Lithovox/lux84/docs/lux84backrender.PNG

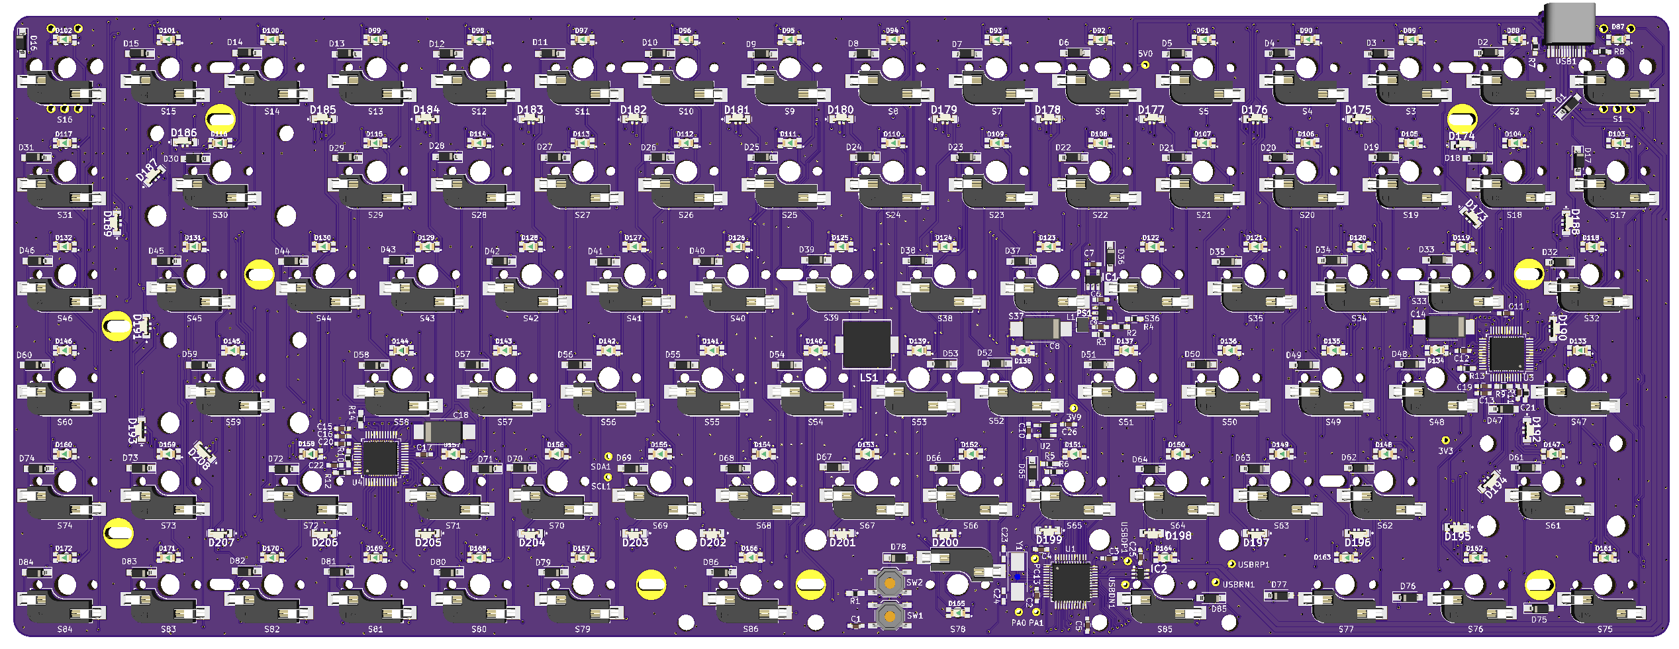
docs/lux84backrender.PNG
