Lithovox/lux84/docs/lux84.pdf

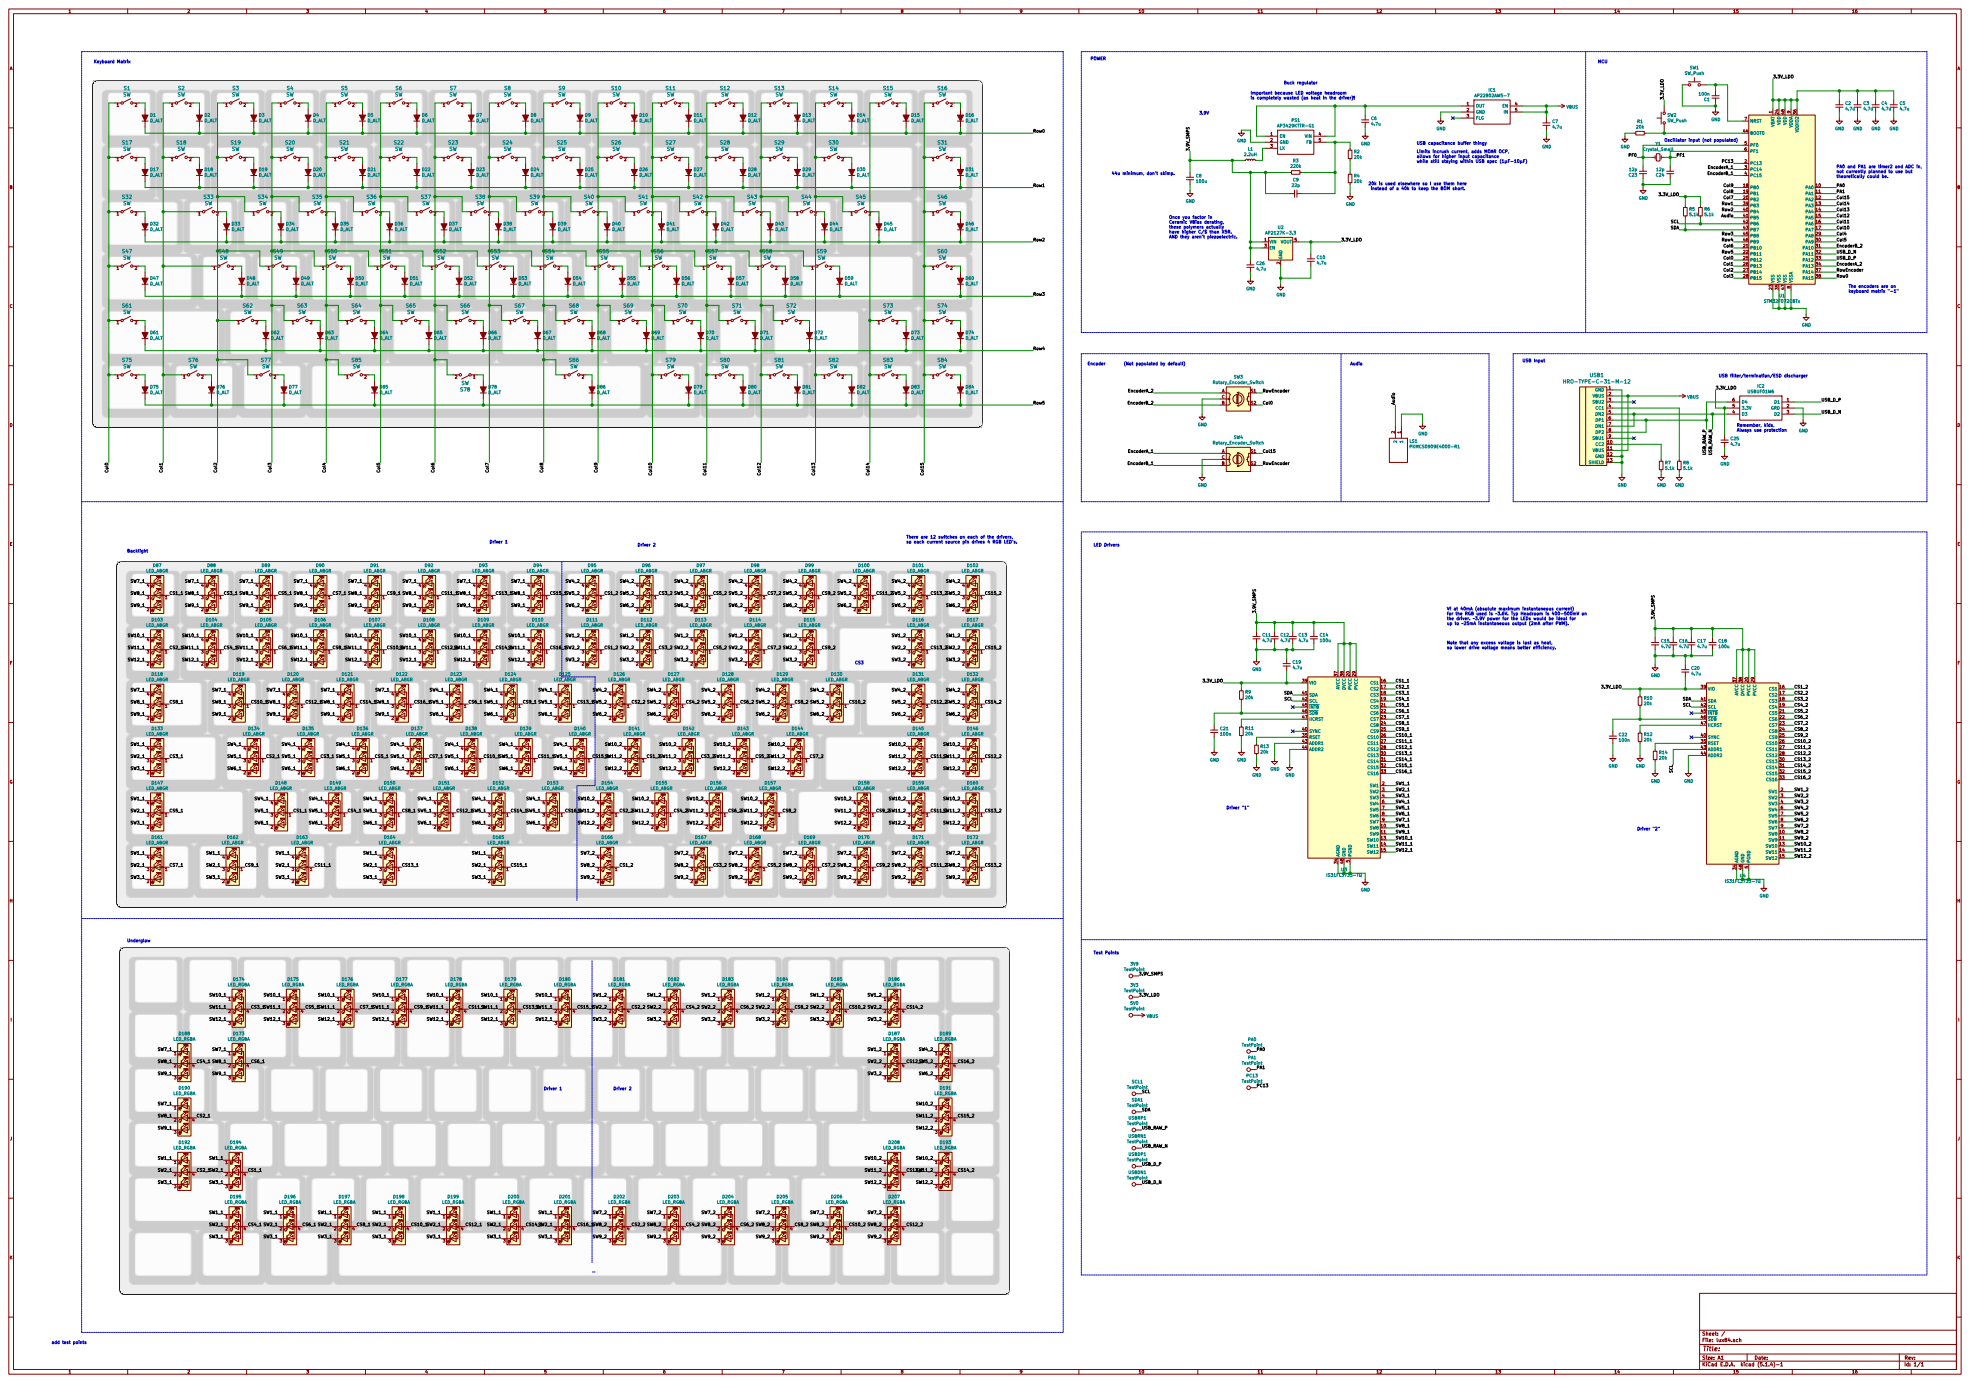
[picture p2: page 1]

Important because LED voltage headroom

9 VDDIO2 36 VSS 23 VSS 35 VSS 47 VSSA

USB capacitance buffer thingy
Limits incrush current, adds MOAR OCP, allows for higher input capacitance

while still staying within USB spec (1µF-10µF)

20k is used elsewhere so I use them here

Once you factor in
Ceramic VBias derating,
these polymers actually
have higher C/$ than X5R.
AND they aren't piezoelectric.

USB filter/termination/ESD discharger Driver 2

Vf at 40mA (absolute maximum instantaneous current)
for the RGB used is 3.6V. Typ Headroom is 400-500mV on
the driver. 3.9V power for the LEDs would be ideal for

up to 25mA instantaneous output (2mA after PWM).

Note that any excess voltage is lost as heat,

Id: 1/1 Title: File: lux84.sch Sheet: /
