Lithovox/lux84/docs/lux84-pcb-rear.pdf

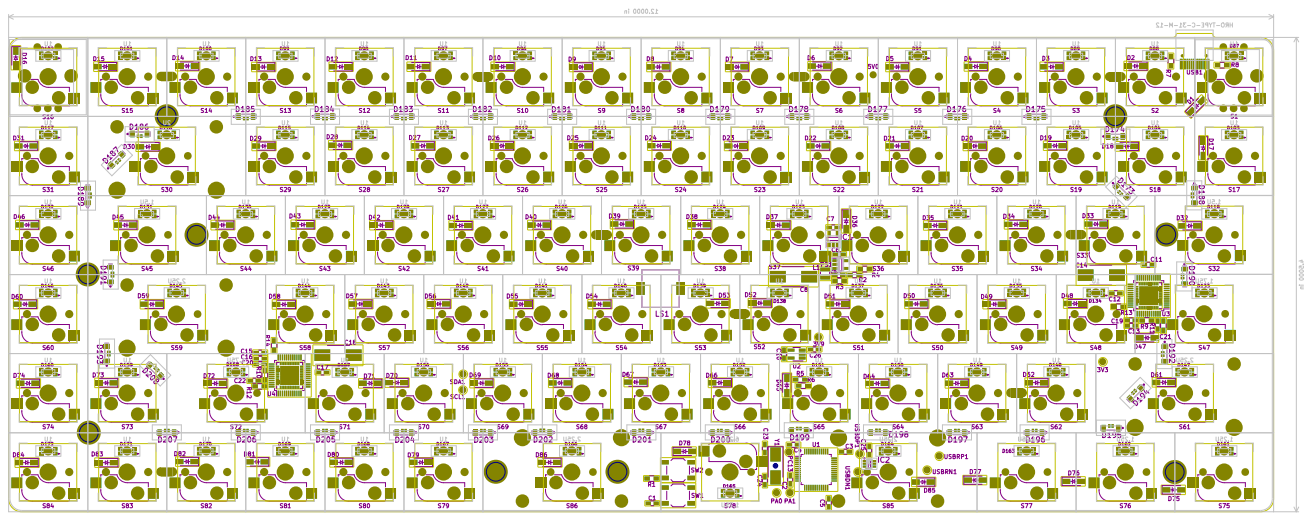
[picture p3: page 1]
