Lithovox/lux84/docs/lux84-pcb.pdf

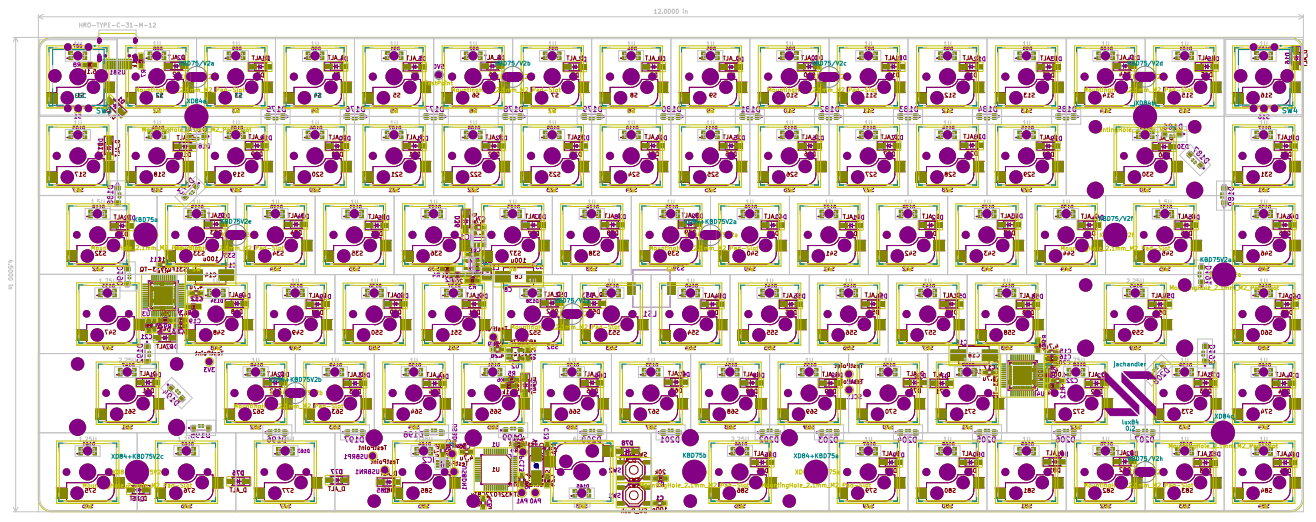
[picture p4: page 1]
