Lithovox/lux84/lux84.sch

## KiCad design lux84.sch (2021-03-26)

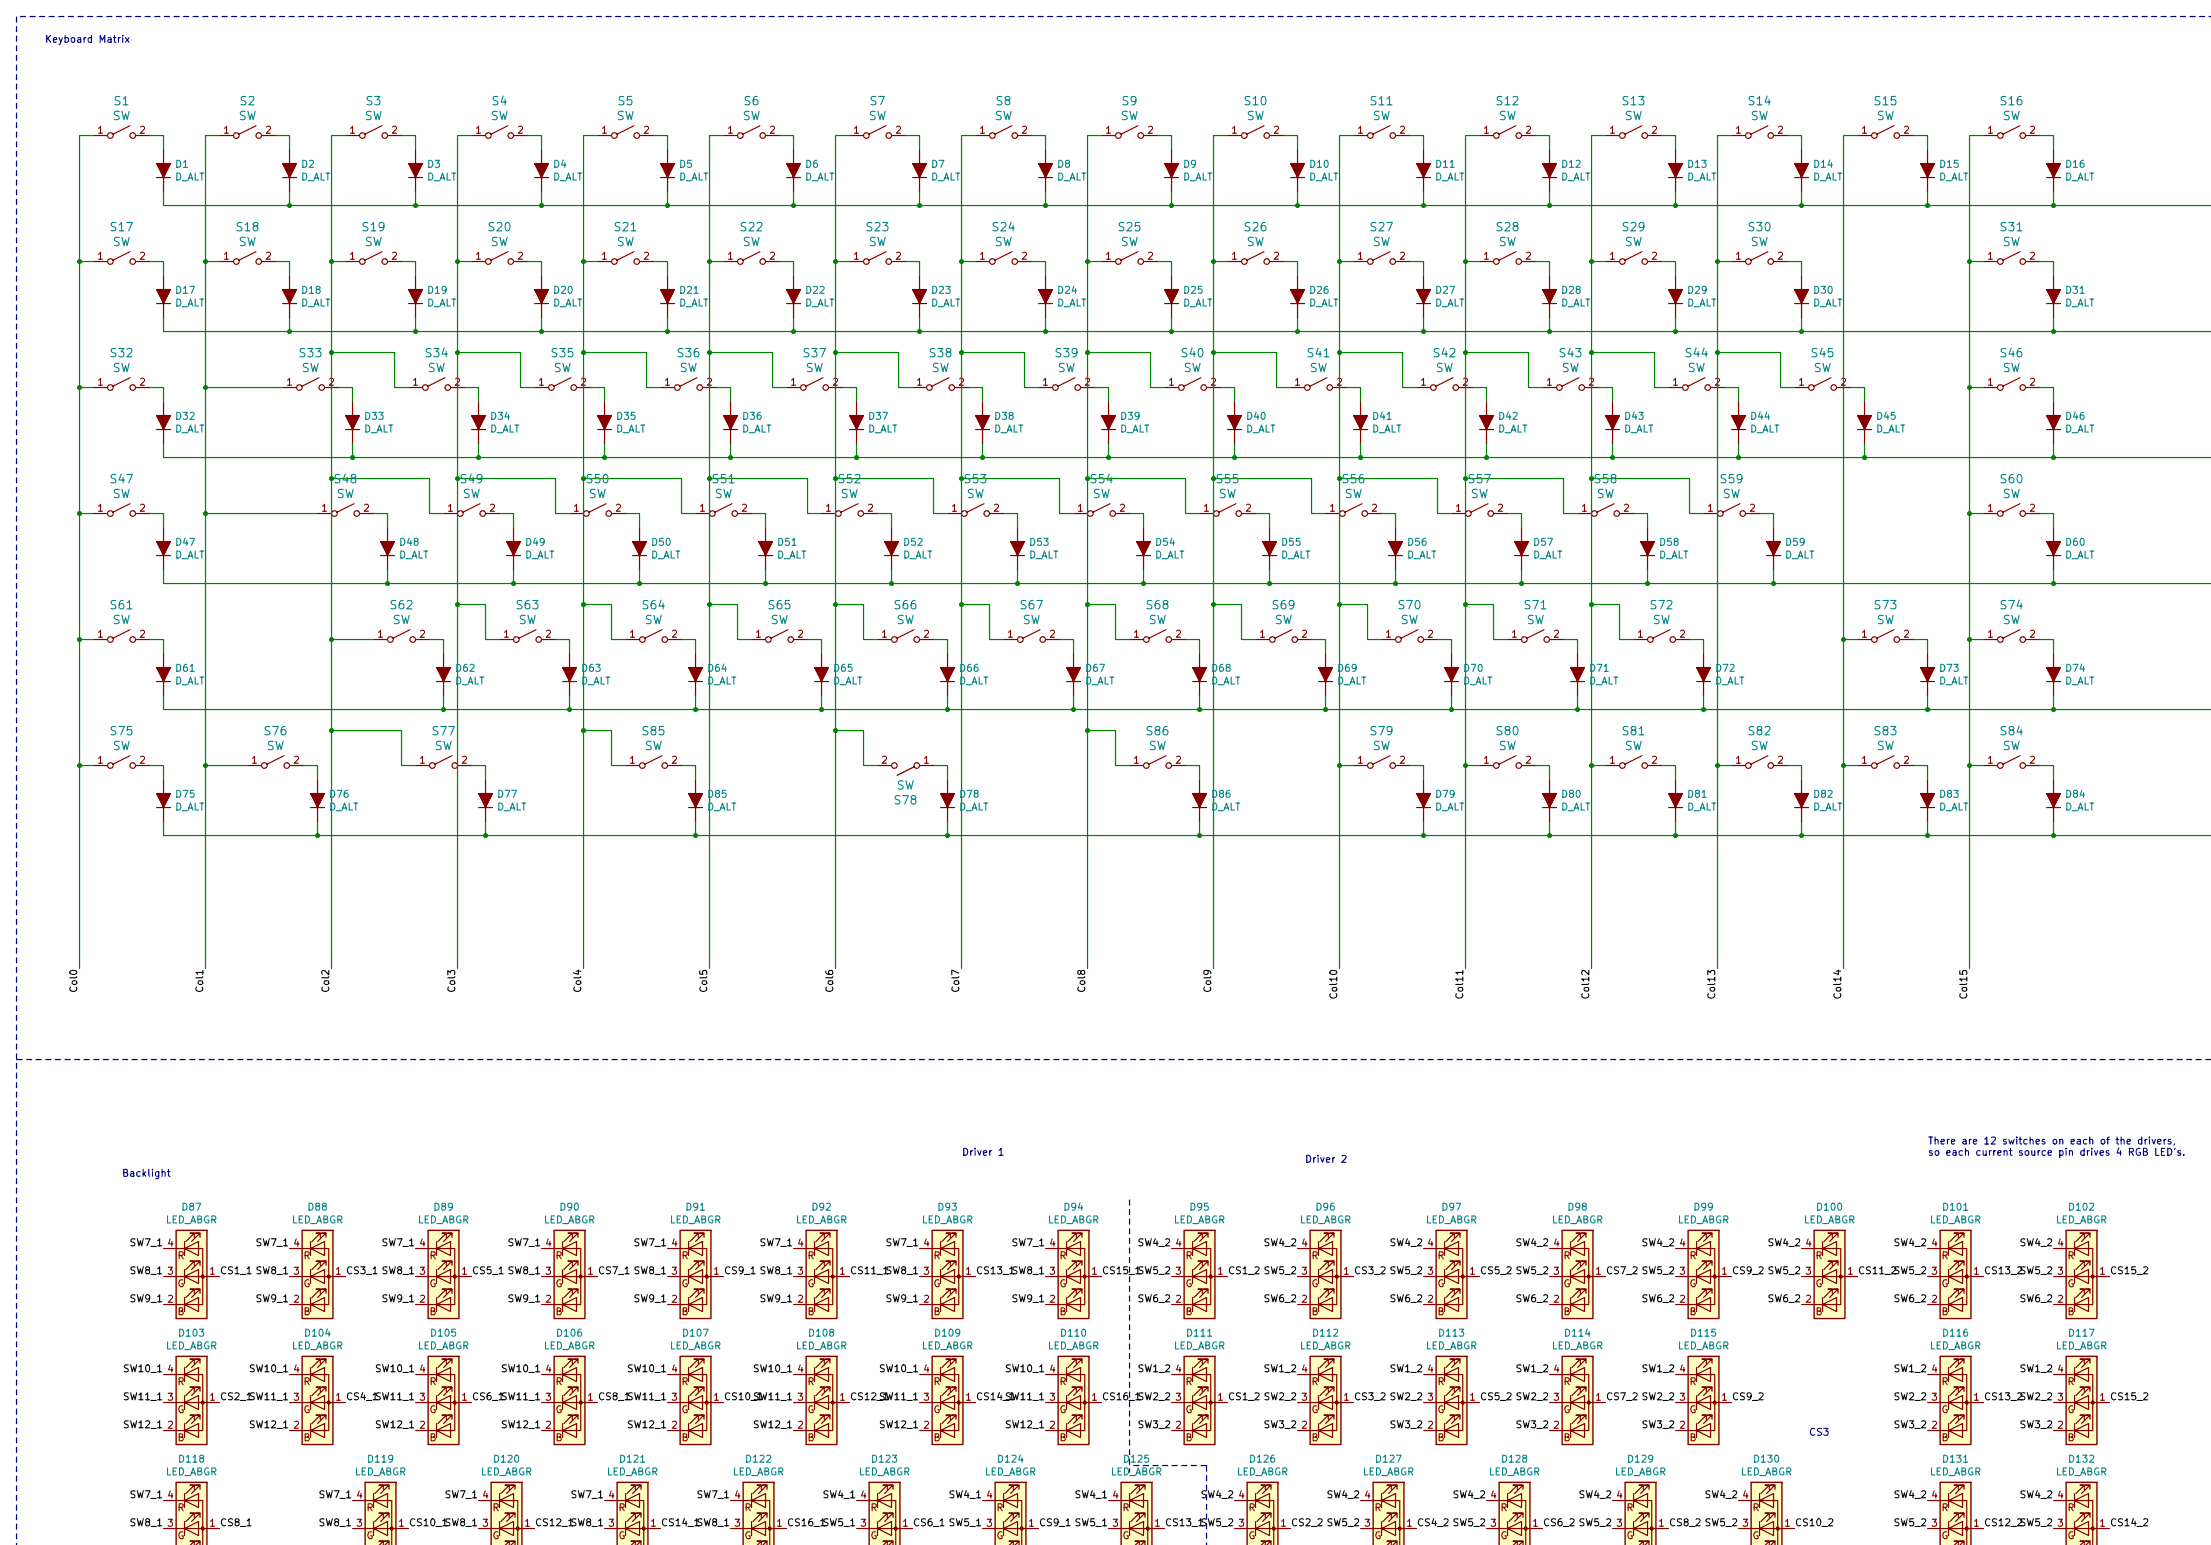
[picture p5: schematic lux84.sch, part in row 1, column 1]

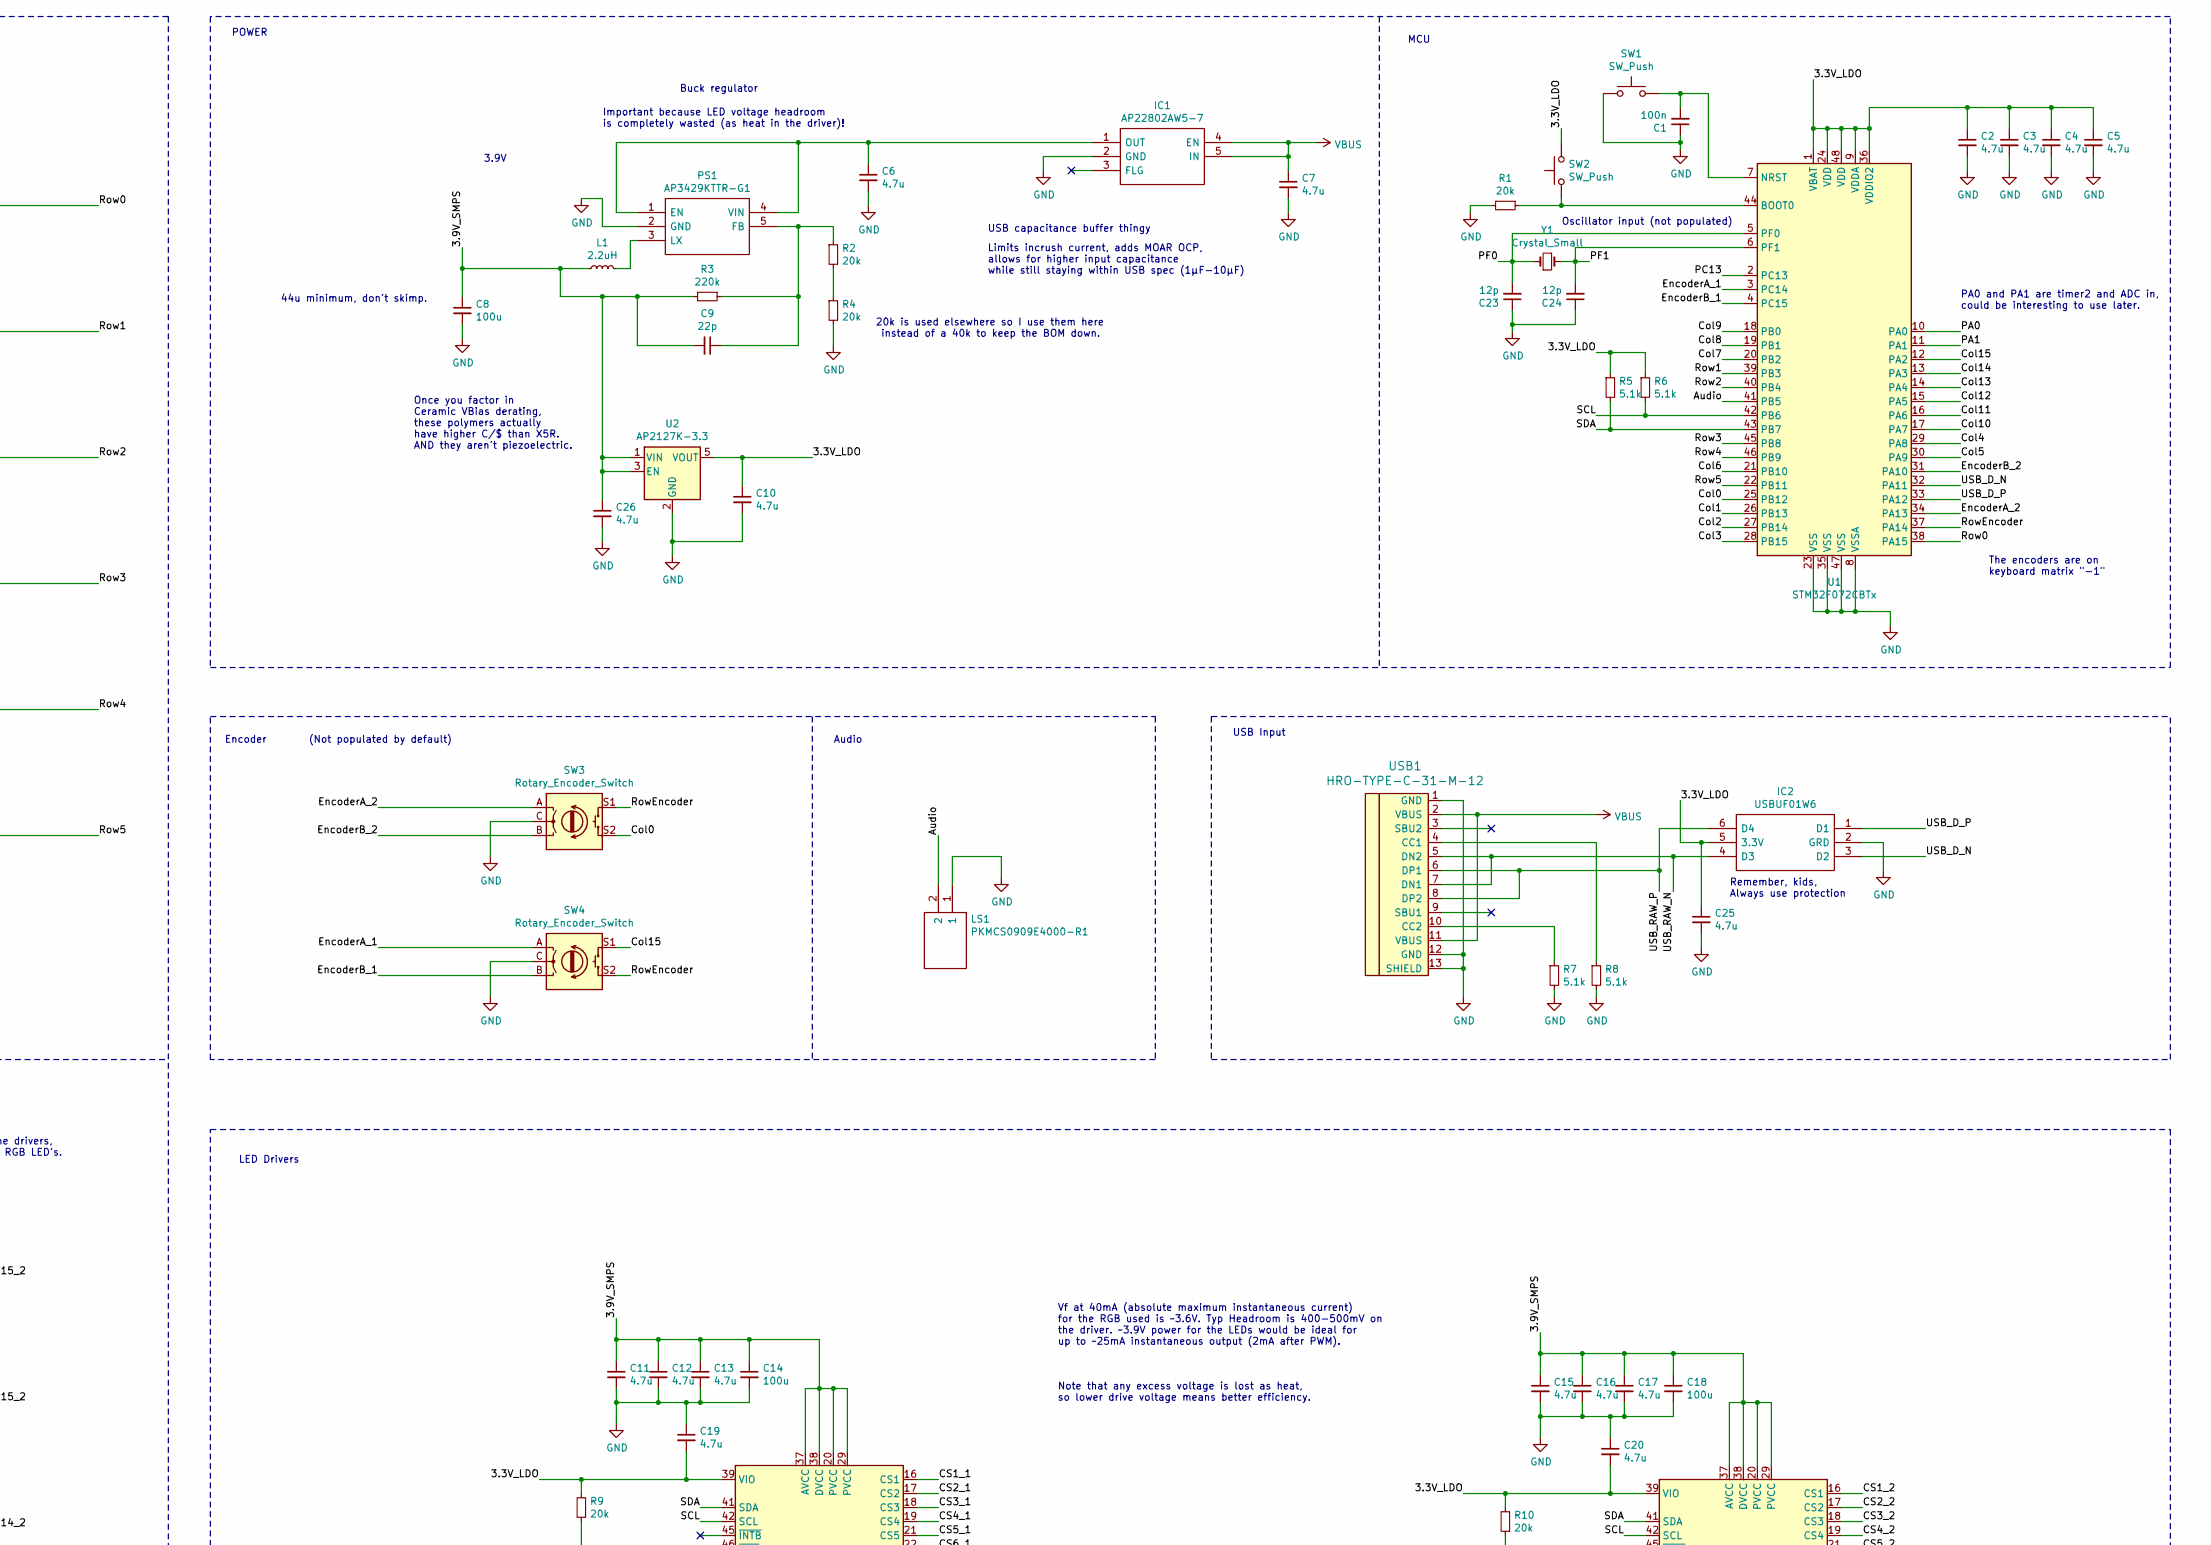
[picture p6: schematic lux84.sch, part in row 1, column 2]

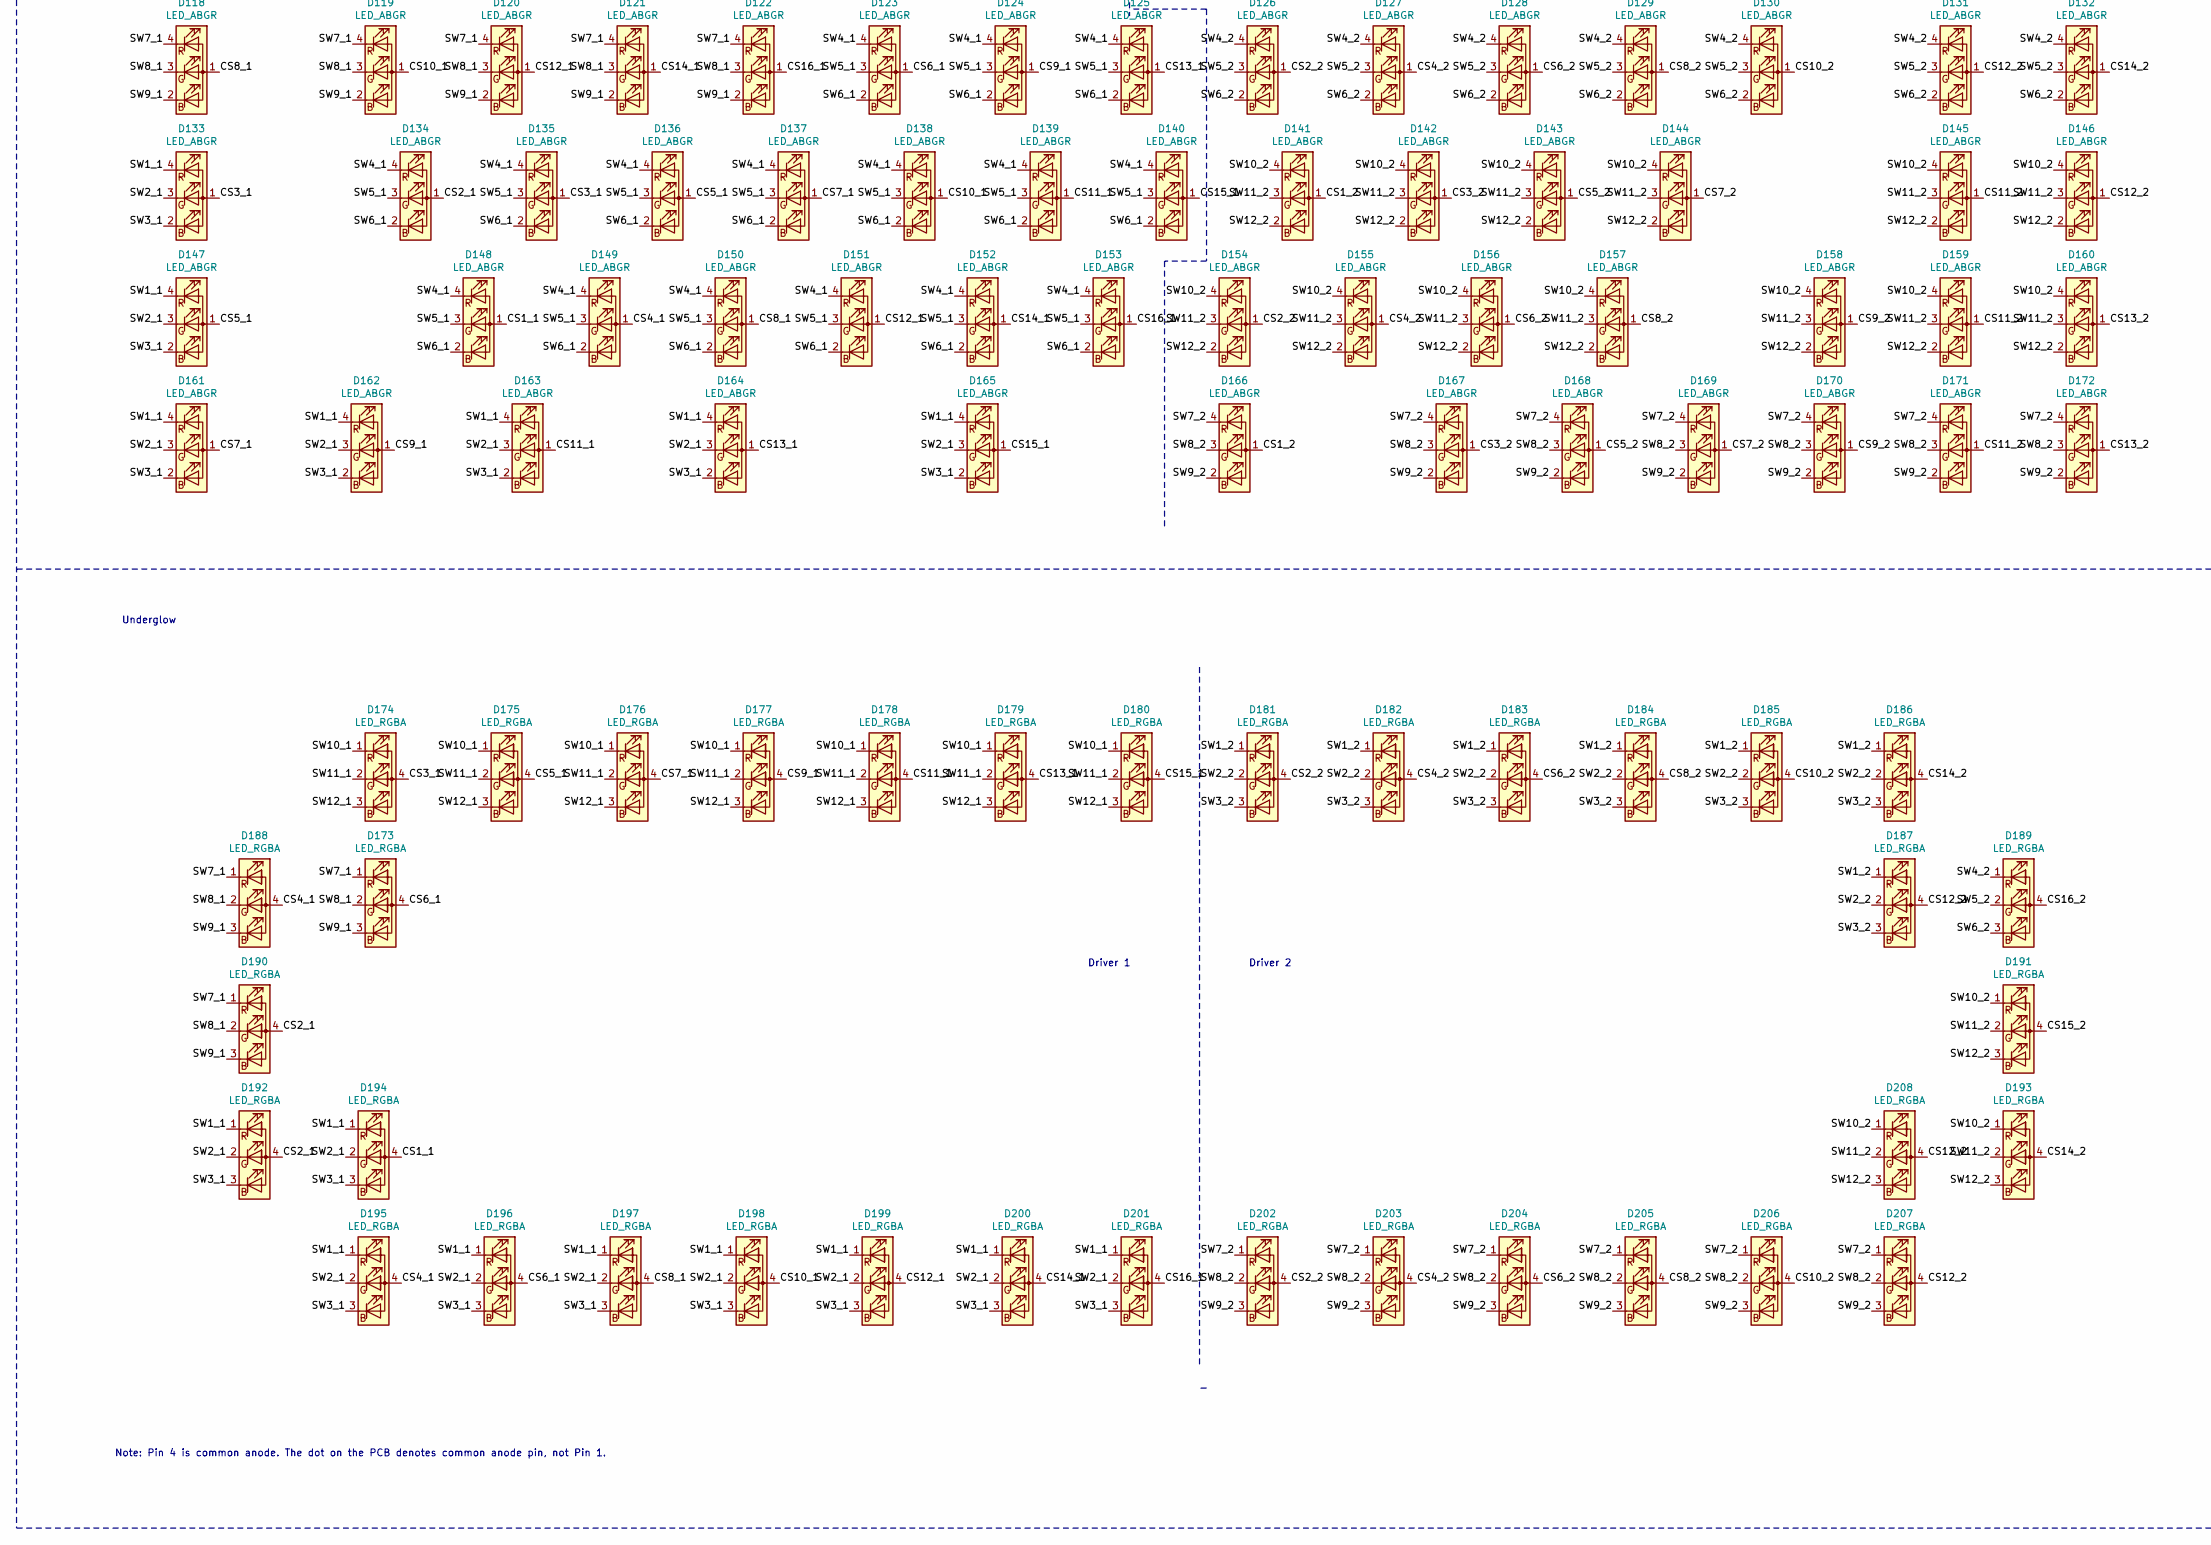
[picture p7: schematic lux84.sch, part in row 2, column 1]

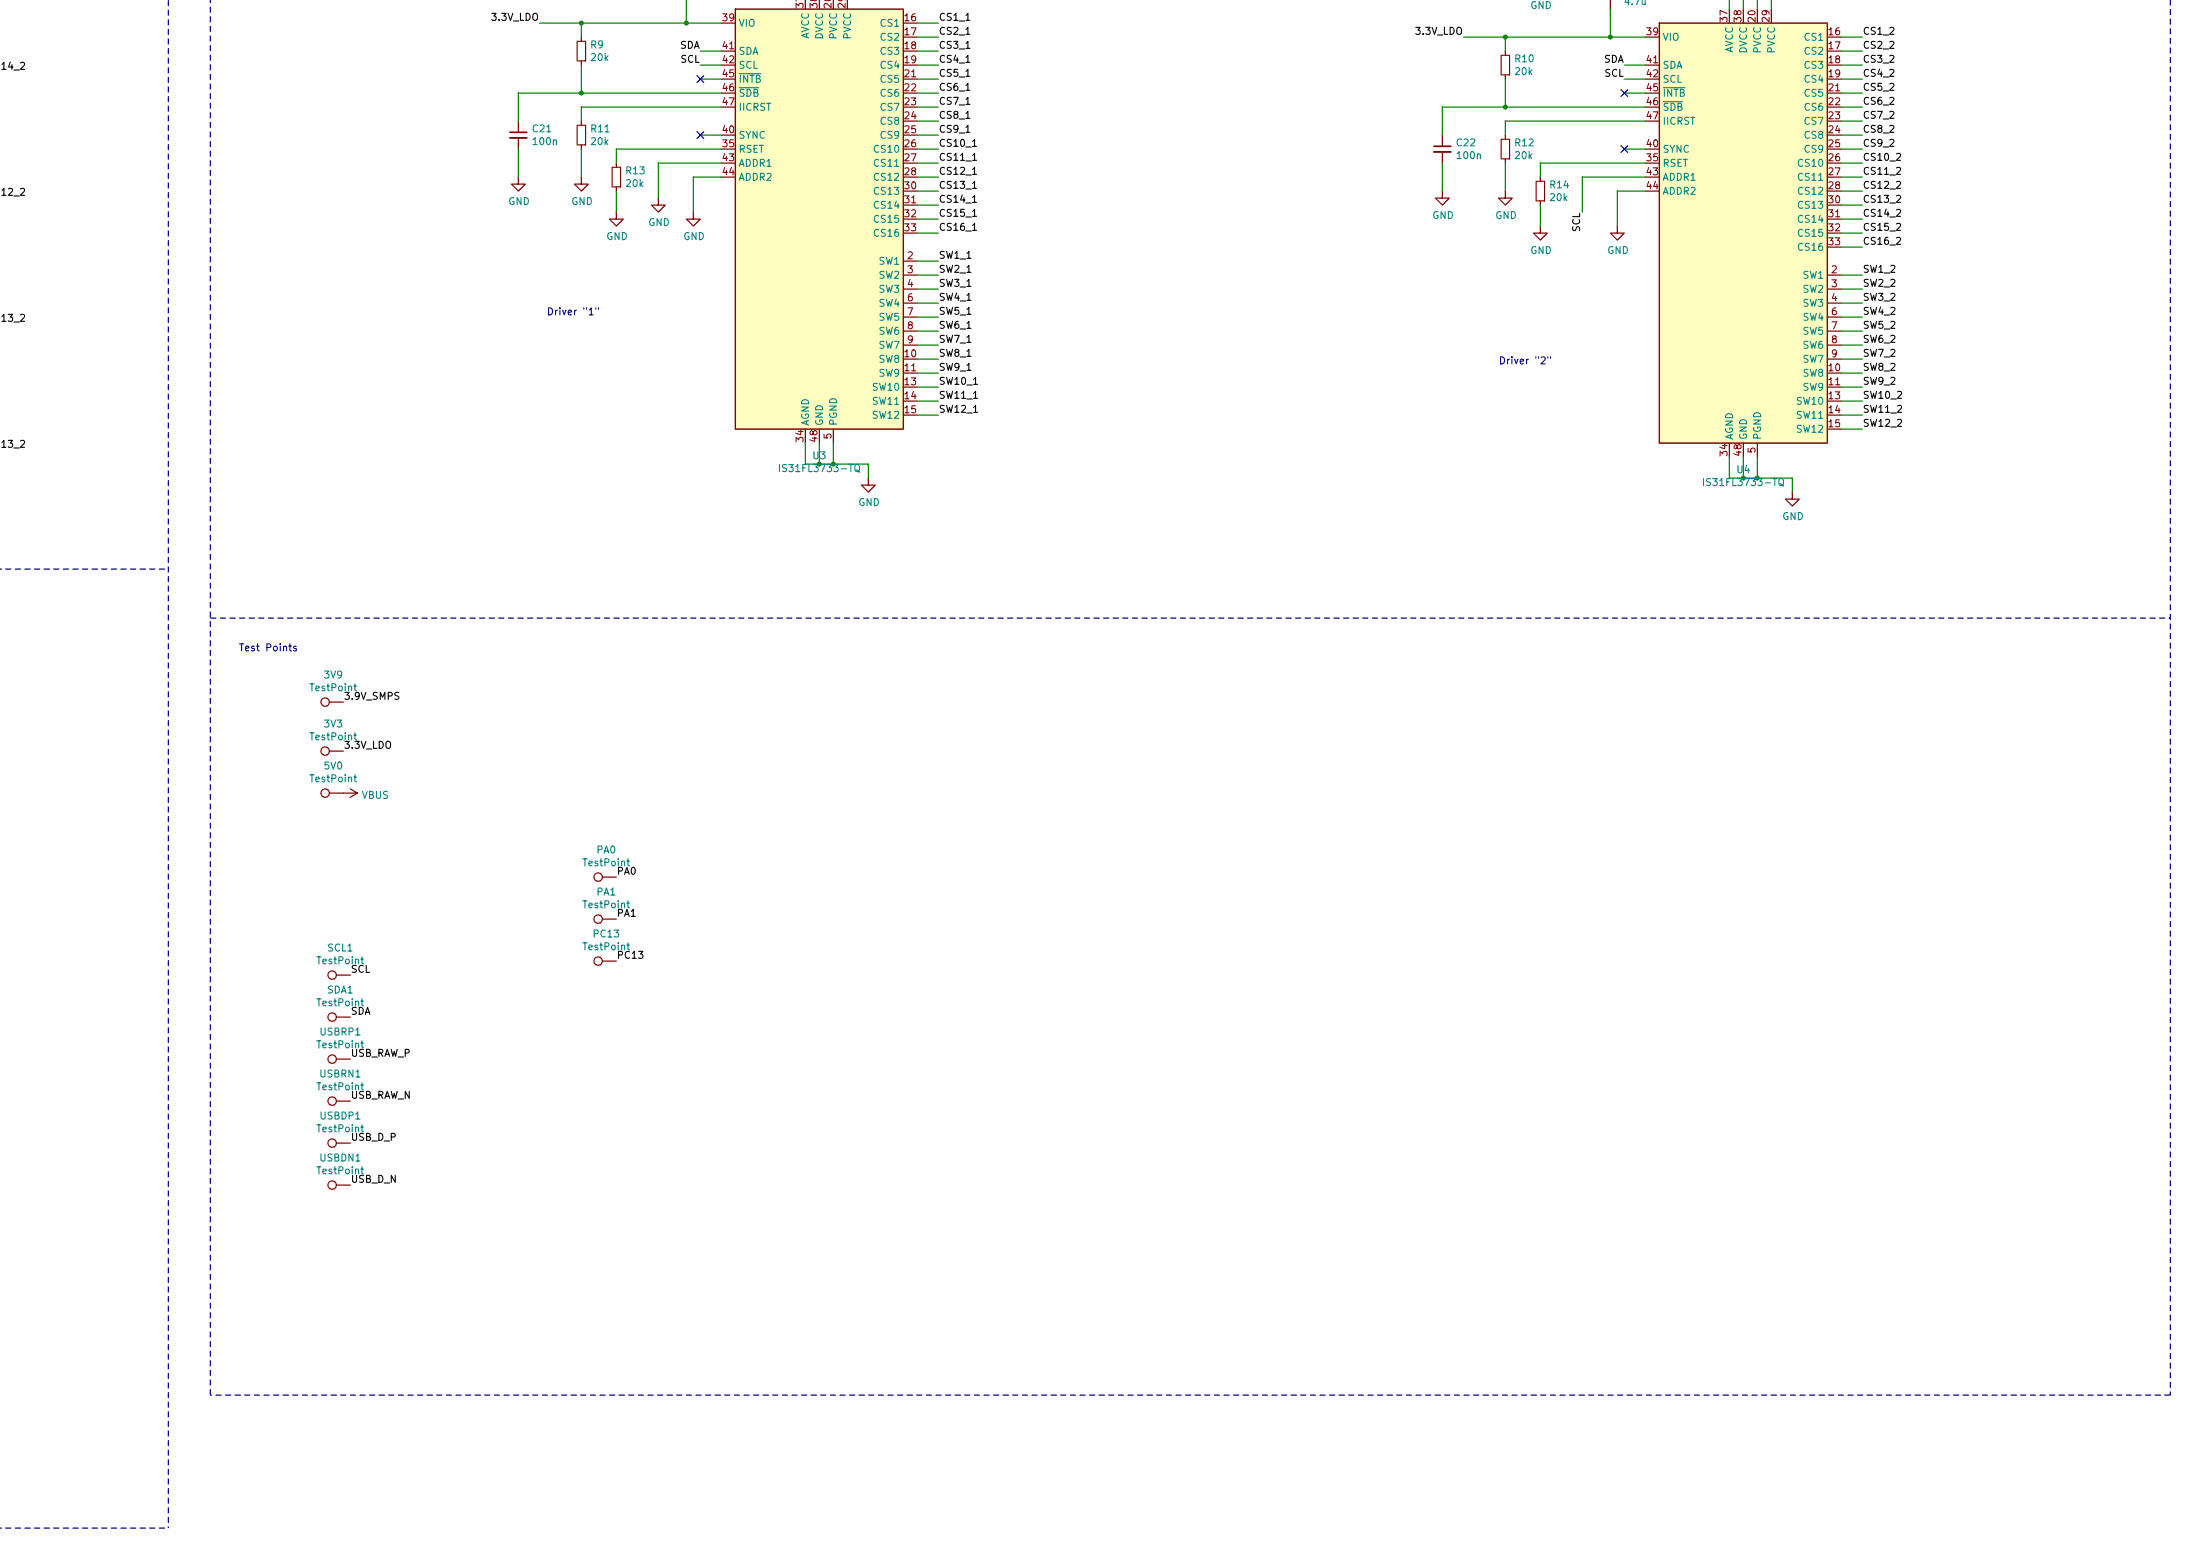
[picture p8: schematic lux84.sch, part in row 2, column 2]

Parts:
3V3, 3V9, 5V0: TestPoint; Measurement_Point_Round-TH_Small
C1, C21, C22: 100n; C_0603_HandSoldering
C2, C3, C4, C5, C6, C7, C10, C11, C12, C13, C15, C16, C17, C19, C20, C25, C26: 4.7u; C_0603_HandSoldering
C8, C14, C18: 100u; 7343-Nonpolar_Hand
C9: 22p; C_0603_HandSoldering
C23, C24: 12p; C_0603_HandSoldering_Nopop
D1, D2, D3, D4, D5, D6, D7, D8, D9, D10, D11, D12, D13, D14, D15, D16, D17, D18, D19, D20, D21, D22, D23, D24, D25, D26, D27, D28, D29, D30, D31, D32, D33, D34, D35, D36, D37, D38, D39, D40, D41, D42, D43, D44, D45, D46, D47, D48, D49, D50, D51, D52, D53, D54, D55, D56, D57, D58, D59, D60, D61, D62, D63, D64, D65, D66, D67, D68, D69, D70, D71, D72, D73, D74, D75, D76, D77, D78, D79, D80, D81, D82, D83, D84, D85, D86: D_ALT; D_SOD-123-Hand+SS
D87, D88, D89, D90, D91, D92, D93, D94, D95, D96, D97, D98, D99, D100, D101, D102, D103, D104, D105, D106, D107, D108, D109, D110, D111, D112, D113, D114, D115, D116, D117, D118, D119, D120, D121, D122, D123, D124, D125, D126, D127, D128, D129, D130, D131, D132, D133, D134, D135, D136, D137, D138, D139, D140, D141, D142, D143, D144, D145, D146, D147, D148, D149, D150, D151, D152, D153, D154, D155, D156, D157, D158, D159, D160, D161, D162, D163, D164, D165, D166, D167, D168, D169, D170, D171, D172: LED_ABGR; MHT150RGBCT
D173, D174, D175, D176, D177, D178, D179, D180, D181, D182, D183, D184, D185, D186, D187, D188, D189, D190, D191, D192, D193, D194, D195, D196, D197, D198, D199, D200, D201, D202, D203, D204, D205, D206, D207, D208: LED_RGBA; LTSTS310F3WT
IC1: AP22802AW5-7; SOT95P285X130-5N; Manufacturer_Part_Number AP22802AW5-7; Mouser Part Number 621-AP22802AW5-7
IC2: USBUF01W6; SOT65P210X110-6N; Manufacturer_Part_Number USBUF01W6; Mouser Part Number 511-USBUF01W6
L1: 2.2uH; L_Wuerth_MAPI-2512
LS1: PKMCS0909E4000-R1; PKMCS; Manufacturer_Part_Number PKMCS0909E4000-R1; Mouser Part Number 81-PKMCS0909E4000-R1
PA0, PA1: TestPoint; Measurement_Point_Round-TH_Small
PC13: TestPoint; Measurement_Point_Round-TH_Small
PS1: AP3429KTTR-G1; SOT95P285X130-5N; Manufacturer_Part_Number AP3429KTTR-G1; Mouser Part Number 621-AP3429KTTR-G1
R1, R2, R4, R9, R10, R11, R12, R13, R14: 20k; R_0603_HandSoldering
R3: 220k; R_0603_HandSoldering
R5, R6, R7, R8: 5.1k; R_0603_HandSoldering
S1, S16: SW; Kailh_socket_MX_1U-encodermount
S2, S3, S4, S5, S6, S7, S8, S9, S10, S11, S12, S13, S14, S15, S17, S18, S19, S20, S21, S22, S23, S24, S25, S26, S27, S28, S29, S31, S33, S34, S35, S36, S37, S38, S39, S40, S41, S42, S43, S44, S46, S48, S49, S50, S51, S52, S53, S54, S55, S56, S57, S58, S60, S62, S63, S64, S65, S66, S67, S68, S69, S70, S71, S73, S74, S79, S80, S81, S82, S83, S84: SW; Kailh_socket_MX_1U
S30: SW; Kailh_socket_MX_2U
S32, S45: SW; Kailh_socket_MX_1.5U
S47, S72, S78: SW; Kailh_socket_MX_1.75U
S59, S61: SW; Kailh_socket_MX_2.25U
S75, S76, S77: SW; Kailh_socket_MX_1.25U
S85, S86: SW; Kailh_socket_MX_2.25U-flippedstabs
SCL1: TestPoint; Measurement_Point_Round-TH_Small
SDA1: TestPoint; Measurement_Point_Round-TH_Small
SW1, SW2: SW_Push; SW_SPST_TL3342
SW3, SW4: Rotary_Encoder_Switch; PEC11R4220KS0024-encoderdown
U1: STM32F072CBTx; LQFP-48_7x7mm_Pitch0.5mm
U2: AP2127K-3.3; SOT-23-5_HandSoldering
U3, U4: IS31FL3733-TQ; ComboQFN+QFP(48)-under6mil
USB1: HRO-TYPE-C-31-M-12; HRO-TYPE-C-31-M-12-HandSoldering
USBDN1: TestPoint; Measurement_Point_Round-TH_Small
USBDP1: TestPoint; Measurement_Point_Round-TH_Small
USBRN1: TestPoint; Measurement_Point_Round-TH_Small
USBRP1: TestPoint; Measurement_Point_Round-TH_Small
Y1: Crystal_Small; Crystal_SMD_Abracon_ABM3-2pin_5.0x3.2mm_HandSoldering

Connections:
3.3V_LDO: 3V3.1, C2.1, C3.1, C4.1, C5.1, C10.1, C19.2, C20.2, C25.1, IC2.5 (3.3V), R5.1, R6.1, R9.2, R10.2, SW2.2, U1.1 (VBAT), U1.9 (VDDA), U1.24 (VDD), U1.36 (VDDIO2), U1.48 (VDD), U2.5 (VOUT), U3.39 (VIO), U4.39 (VIO)
3.9V_SMPS: 3V9.1, C8.1, C9.2, C11.1, C12.1, C13.1, C14.1, C15.1, C16.1, C17.1, C18.1, C26.1, L1.1, R3.2, U2.1 (VIN), U2.3 (EN), U3.20 (PVCC), U3.29 (PVCC), U3.37 (AVCC), U3.38 (DVCC), U4.20 (PVCC), U4.29 (PVCC), U4.37 (AVCC), U4.38 (DVCC)
Audio: LS1.2, U1.41 (PB5)
CS1_1: D87.1 (A), D148.1 (A), D194.4 (A), U3.16 (CS1)
CS1_2: D95.1 (A), D111.1 (A), D141.1 (A), D166.1 (A), U4.16 (CS1)
CS2_1: D103.1 (A), D134.1 (A), D190.4 (A), D192.4 (A), U3.17 (CS2)
CS2_2: D126.1 (A), D154.1 (A), D181.4 (A), D202.4 (A), U4.17 (CS2)
CS3_1: D88.1 (A), D133.1 (A), D135.1 (A), D174.4 (A), U3.18 (CS3)
CS3_2: D96.1 (A), D112.1 (A), D142.1 (A), D167.1 (A), U4.18 (CS3)
CS4_1: D104.1 (A), D149.1 (A), D188.4 (A), D195.4 (A), U3.19 (CS4)
CS4_2: D127.1 (A), D155.1 (A), D182.4 (A), D203.4 (A), U4.19 (CS4)
CS5_1: D89.1 (A), D136.1 (A), D147.1 (A), D175.4 (A), U3.21 (CS5)
CS5_2: D97.1 (A), D113.1 (A), D143.1 (A), D168.1 (A), U4.21 (CS5)
CS6_1: D105.1 (A), D123.1 (A), D173.4 (A), D196.4 (A), U3.22 (CS6)
CS6_2: D128.1 (A), D156.1 (A), D183.4 (A), D204.4 (A), U4.22 (CS6)
CS7_1: D90.1 (A), D137.1 (A), D161.1 (A), D176.4 (A), U3.23 (CS7)
CS7_2: D98.1 (A), D114.1 (A), D144.1 (A), D169.1 (A), U4.23 (CS7)
CS8_1: D106.1 (A), D118.1 (A), D150.1 (A), D197.4 (A), U3.24 (CS8)
CS8_2: D129.1 (A), D157.1 (A), D184.4 (A), D205.4 (A), U4.24 (CS8)
CS9_1: D91.1 (A), D124.1 (A), D162.1 (A), D177.4 (A), U3.25 (CS9)
CS9_2: D99.1 (A), D115.1 (A), D158.1 (A), D170.1 (A), U4.25 (CS9)
CS10_1: D107.1 (A), D119.1 (A), D138.1 (A), D198.4 (A), U3.26 (CS10)
CS10_2: D130.1 (A), D185.4 (A), D206.4 (A), U4.26 (CS10)
CS11_1: D92.1 (A), D139.1 (A), D163.1 (A), D178.4 (A), U3.27 (CS11)
CS11_2: D100.1 (A), D145.1 (A), D159.1 (A), D171.1 (A), U4.27 (CS11)
CS12_1: D108.1 (A), D120.1 (A), D151.1 (A), D199.4 (A), U3.28 (CS12)
CS12_2: D131.1 (A), D146.1 (A), D187.4 (A), D207.4 (A), D208.4 (A), U4.28 (CS12)
CS13_1: D93.1 (A), D125.1 (A), D164.1 (A), D179.4 (A), U3.30 (CS13)
CS13_2: D101.1 (A), D116.1 (A), D160.1 (A), D172.1 (A), U4.30 (CS13)
CS14_1: D109.1 (A), D121.1 (A), D152.1 (A), D200.4 (A), U3.31 (CS14)
CS14_2: D132.1 (A), D186.4 (A), D193.4 (A), U4.31 (CS14)
CS15_1: D94.1 (A), D140.1 (A), D165.1 (A), D180.4 (A), U3.32 (CS15)
CS15_2: D102.1 (A), D117.1 (A), D191.4 (A), U4.32 (CS15)
CS16_1: D110.1 (A), D122.1 (A), D153.1 (A), D201.4 (A), U3.33 (CS16)
CS16_2: D189.4 (A), U4.33 (CS16)
Col0: S1.1 (A), S17.1 (A), S32.1 (A), S47.1 (A), S61.1 (A), S75.1 (A), SW3.S2, U1.25 (PB12)
Col1: S2.1 (A), S18.1 (A), S33.1 (A), S48.1 (A), S76.1 (A), U1.26 (PB13)
Col2: S3.1 (A), S19.1 (A), S34.1 (A), S49.1 (A), S62.1 (A), S77.1 (A), U1.27 (PB14)
Col3: S4.1 (A), S20.1 (A), S35.1 (A), S50.1 (A), S63.1 (A), U1.28 (PB15)
Col4: S5.1 (A), S21.1 (A), S36.1 (A), S51.1 (A), S64.1 (A), S85.1 (A), U1.29 (PA8)
Col5: S6.1 (A), S22.1 (A), S37.1 (A), S52.1 (A), S65.1 (A), U1.30 (PA9)
Col6: S7.1 (A), S23.1 (A), S38.1 (A), S53.1 (A), S66.1 (A), S78.2 (B), U1.21 (PB10)
Col7: S8.1 (A), S24.1 (A), S39.1 (A), S54.1 (A), S67.1 (A), U1.20 (PB2)
Col8: S9.1 (A), S25.1 (A), S40.1 (A), S55.1 (A), S68.1 (A), S86.1 (A), U1.19 (PB1)
Col9: S10.1 (A), S26.1 (A), S41.1 (A), S56.1 (A), S69.1 (A), U1.18 (PB0)
Col10: S11.1 (A), S27.1 (A), S42.1 (A), S57.1 (A), S70.1 (A), S79.1 (A), U1.17 (PA7)
Col11: S12.1 (A), S28.1 (A), S43.1 (A), S58.1 (A), S71.1 (A), S80.1 (A), U1.16 (PA6)
Col12: S13.1 (A), S29.1 (A), S44.1 (A), S59.1 (A), S72.1 (A), S81.1 (A), U1.15 (PA5)
Col13: S14.1 (A), S30.1 (A), S45.1 (A), S82.1 (A), U1.14 (PA4)
Col14: S15.1 (A), S73.1 (A), S83.1 (A), U1.13 (PA3)
Col15: S16.1 (A), S31.1 (A), S46.1 (A), S60.1 (A), S74.1 (A), S84.1 (A), SW4.S1, U1.12 (PA2)
EncoderA_1: SW4.A, U1.3 (PC14)
EncoderA_2: SW3.A, U1.34 (PA13)
EncoderB_1: SW4.B, U1.4 (PC15)
EncoderB_2: SW3.B, U1.31 (PA10)
GND: C1.1, C2.2, C3.2, C4.2, C5.2, C6.2, C7.2, C8.2, C10.2, C11.2, C12.2, C13.2, C14.2, C15.2, C16.2, C17.2, C18.2, C19.1, C20.1, C21.2, C22.2, C23.1, C24.1, C25.2, C26.2, IC1.2 (GND), IC2.2 (GRD), LS1.1, PS1.2 (GND), R1.2, R4.2, R7.2, R8.2, R11.1, R12.1, R13.1, R14.1, SW1.1, SW3.C, SW4.C, U1.8 (VSSA), U1.23 (VSS), U1.35 (VSS), U1.47 (VSS), U2.2 (GND), U3.5 (PGND), U3.12 (PGND), U3.34 (AGND), U3.43 (ADDR1), U3.44 (ADDR2), U3.48 (GND), U3.49 (GND), U4.5 (PGND), U4.12 (PGND), U4.34 (AGND), U4.44 (ADDR2), U4.48 (GND), U4.49 (GND), USB1.1 (GND), USB1.12 (GND), USB1.13 (SHIELD)
unnamed: C1.2, SW1.2, U1.7 (NRST)
unnamed: C6.1, IC1.1 (OUT), PS1.1 (EN), PS1.4 (VIN)
unnamed: C9.1, PS1.5 (FB), R2.1, R3.1
unnamed: C21.1, R9.1, U3.46 (~SDB)
unnamed: C22.1, R10.1, U4.46 (~SDB)
unnamed: D1.2 (A), S1.2 (B)
unnamed: D2.2 (A), S2.2 (B)
unnamed: D3.2 (A), S3.2 (B)
unnamed: D4.2 (A), S4.2 (B)
unnamed: D5.2 (A), S5.2 (B)
unnamed: D6.2 (A), S6.2 (B)
unnamed: D7.2 (A), S7.2 (B)
unnamed: D8.2 (A), S8.2 (B)
unnamed: D9.2 (A), S9.2 (B)
unnamed: D10.2 (A), S10.2 (B)
unnamed: D11.2 (A), S11.2 (B)
unnamed: D12.2 (A), S12.2 (B)
unnamed: D13.2 (A), S13.2 (B)
unnamed: D14.2 (A), S14.2 (B)
unnamed: D15.2 (A), S15.2 (B)
unnamed: D16.2 (A), S16.2 (B)
unnamed: D17.2 (A), S17.2 (B)
unnamed: D18.2 (A), S18.2 (B)
unnamed: D19.2 (A), S19.2 (B)
unnamed: D20.2 (A), S20.2 (B)
unnamed: D21.2 (A), S21.2 (B)
unnamed: D22.2 (A), S22.2 (B)
unnamed: D23.2 (A), S23.2 (B)
unnamed: D24.2 (A), S24.2 (B)
unnamed: D25.2 (A), S25.2 (B)
unnamed: D26.2 (A), S26.2 (B)
unnamed: D27.2 (A), S27.2 (B)
unnamed: D28.2 (A), S28.2 (B)
unnamed: D29.2 (A), S29.2 (B)
unnamed: D30.2 (A), S30.2 (B)
unnamed: D31.2 (A), S31.2 (B)
unnamed: D32.2 (A), S32.2 (B)
unnamed: D33.2 (A), S33.2 (B)
unnamed: D34.2 (A), S34.2 (B)
unnamed: D35.2 (A), S35.2 (B)
unnamed: D36.2 (A), S36.2 (B)
unnamed: D37.2 (A), S37.2 (B)
unnamed: D38.2 (A), S38.2 (B)
unnamed: D39.2 (A), S39.2 (B)
unnamed: D40.2 (A), S40.2 (B)
unnamed: D41.2 (A), S41.2 (B)
unnamed: D42.2 (A), S42.2 (B)
unnamed: D43.2 (A), S43.2 (B)
unnamed: D44.2 (A), S44.2 (B)
unnamed: D45.2 (A), S45.2 (B)
unnamed: D46.2 (A), S46.2 (B)
unnamed: D47.2 (A), S47.2 (B)
unnamed: D48.2 (A), S48.2 (B)
unnamed: D49.2 (A), S49.2 (B)
unnamed: D50.2 (A), S50.2 (B)
unnamed: D51.2 (A), S51.2 (B)
unnamed: D52.2 (A), S52.2 (B)
unnamed: D53.2 (A), S53.2 (B)
unnamed: D54.2 (A), S54.2 (B)
unnamed: D55.2 (A), S55.2 (B)
unnamed: D56.2 (A), S56.2 (B)
unnamed: D57.2 (A), S57.2 (B)
unnamed: D58.2 (A), S58.2 (B)
unnamed: D59.2 (A), S59.2 (B)
unnamed: D60.2 (A), S60.2 (B)
unnamed: D61.2 (A), S61.2 (B)
unnamed: D62.2 (A), S62.2 (B)
unnamed: D63.2 (A), S63.2 (B)
unnamed: D64.2 (A), S64.2 (B)
unnamed: D65.2 (A), S65.2 (B)
unnamed: D66.2 (A), S66.2 (B)
unnamed: D67.2 (A), S67.2 (B)
unnamed: D68.2 (A), S68.2 (B)
unnamed: D69.2 (A), S69.2 (B)
unnamed: D70.2 (A), S70.2 (B)
unnamed: D71.2 (A), S71.2 (B)
unnamed: D72.2 (A), S72.2 (B)
unnamed: D73.2 (A), S73.2 (B)
unnamed: D74.2 (A), S74.2 (B)
unnamed: D75.2 (A), S75.2 (B)
unnamed: D76.2 (A), S76.2 (B)
unnamed: D77.2 (A), S77.2 (B)
unnamed: D78.2 (A), S78.1 (A)
unnamed: D79.2 (A), S79.2 (B)
unnamed: D80.2 (A), S80.2 (B)
unnamed: D81.2 (A), S81.2 (B)
unnamed: D82.2 (A), S82.2 (B)
unnamed: D83.2 (A), S83.2 (B)
unnamed: D84.2 (A), S84.2 (B)
unnamed: D85.2 (A), S85.2 (B)
unnamed: D86.2 (A), S86.2 (B)
unnamed: L1.2, PS1.3 (LX)
unnamed: R1.1, SW2.1, U1.44 (BOOT0)
unnamed: R2.2, R4.1
unnamed: R7.1, USB1.10 (CC2)
unnamed: R8.1, USB1.4 (CC1)
unnamed: R11.2, U3.47 (IICRST)
unnamed: R12.2, U4.47 (IICRST)
unnamed: R13.2, U3.35 (RSET)
unnamed: R14.2, U4.35 (RSET)
PA0: PA0.1, U1.10 (PA0)
PA1: PA1.1, U1.11 (PA1)
PC13: PC13.1, U1.2 (PC13)
PF0: C23.2, U1.5 (PF0), Y1.1
PF1: C24.2, U1.6 (PF1), Y1.2
Row0: D1.1 (K), D2.1 (K), D3.1 (K), D4.1 (K), D5.1 (K), D6.1 (K), D7.1 (K), D8.1 (K), D9.1 (K), D10.1 (K), D11.1 (K), D12.1 (K), D13.1 (K), D14.1 (K), D15.1 (K), D16.1 (K), U1.38 (PA15)
Row1: D17.1 (K), D18.1 (K), D19.1 (K), D20.1 (K), D21.1 (K), D22.1 (K), D23.1 (K), D24.1 (K), D25.1 (K), D26.1 (K), D27.1 (K), D28.1 (K), D29.1 (K), D30.1 (K), D31.1 (K), U1.39 (PB3)
Row2: D32.1 (K), D33.1 (K), D34.1 (K), D35.1 (K), D36.1 (K), D37.1 (K), D38.1 (K), D39.1 (K), D40.1 (K), D41.1 (K), D42.1 (K), D43.1 (K), D44.1 (K), D45.1 (K), D46.1 (K), U1.40 (PB4)
Row3: D47.1 (K), D48.1 (K), D49.1 (K), D50.1 (K), D51.1 (K), D52.1 (K), D53.1 (K), D54.1 (K), D55.1 (K), D56.1 (K), D57.1 (K), D58.1 (K), D59.1 (K), D60.1 (K), U1.45 (PB8)
Row4: D61.1 (K), D62.1 (K), D63.1 (K), D64.1 (K), D65.1 (K), D66.1 (K), D67.1 (K), D68.1 (K), D69.1 (K), D70.1 (K), D71.1 (K), D72.1 (K), D73.1 (K), D74.1 (K), U1.46 (PB9)
Row5: D75.1 (K), D76.1 (K), D77.1 (K), D78.1 (K), D79.1 (K), D80.1 (K), D81.1 (K), D82.1 (K), D83.1 (K), D84.1 (K), D85.1 (K), D86.1 (K), U1.22 (PB11)
RowEncoder: SW3.S1, SW4.S2, U1.37 (PA14)
SCL: R6.2, SCL1.1, U1.42 (PB6), U3.42 (SCL), U4.42 (SCL), U4.43 (ADDR1)
SDA: R5.2, SDA1.1, U1.43 (PB7), U3.41 (SDA), U4.41 (SDA)
SW1_1: D133.4 (RK), D147.4 (RK), D161.4 (RK), D162.4 (RK), D163.4 (RK), D164.4 (RK), D165.4 (RK), D192.1 (RK), D194.1 (RK), D195.1 (RK), D196.1 (RK), D197.1 (RK), D198.1 (RK), D199.1 (RK), D200.1 (RK), D201.1 (RK), U3.2 (SW1)
SW1_2: D111.4 (RK), D112.4 (RK), D113.4 (RK), D114.4 (RK), D115.4 (RK), D116.4 (RK), D117.4 (RK), D181.1 (RK), D182.1 (RK), D183.1 (RK), D184.1 (RK), D185.1 (RK), D186.1 (RK), D187.1 (RK), U4.2 (SW1)
SW2_1: D133.3 (GK), D147.3 (GK), D161.3 (GK), D162.3 (GK), D163.3 (GK), D164.3 (GK), D165.3 (GK), D192.2 (GK), D194.2 (GK), D195.2 (GK), D196.2 (GK), D197.2 (GK), D198.2 (GK), D199.2 (GK), D200.2 (GK), D201.2 (GK), U3.3 (SW2)
SW2_2: D111.3 (GK), D112.3 (GK), D113.3 (GK), D114.3 (GK), D115.3 (GK), D116.3 (GK), D117.3 (GK), D181.2 (GK), D182.2 (GK), D183.2 (GK), D184.2 (GK), D185.2 (GK), D186.2 (GK), D187.2 (GK), U4.3 (SW2)
SW3_1: D133.2 (BK), D147.2 (BK), D161.2 (BK), D162.2 (BK), D163.2 (BK), D164.2 (BK), D165.2 (BK), D192.3 (BK), D194.3 (BK), D195.3 (BK), D196.3 (BK), D197.3 (BK), D198.3 (BK), D199.3 (BK), D200.3 (BK), D201.3 (BK), U3.4 (SW3)
SW3_2: D111.2 (BK), D112.2 (BK), D113.2 (BK), D114.2 (BK), D115.2 (BK), D116.2 (BK), D117.2 (BK), D181.3 (BK), D182.3 (BK), D183.3 (BK), D184.3 (BK), D185.3 (BK), D186.3 (BK), D187.3 (BK), U4.4 (SW3)
SW4_1: D123.4 (RK), D124.4 (RK), D125.4 (RK), D134.4 (RK), D135.4 (RK), D136.4 (RK), D137.4 (RK), D138.4 (RK), D139.4 (RK), D140.4 (RK), D148.4 (RK), D149.4 (RK), D150.4 (RK), D151.4 (RK), D152.4 (RK), D153.4 (RK), U3.6 (SW4)
SW4_2: D95.4 (RK), D96.4 (RK), D97.4 (RK), D98.4 (RK), D99.4 (RK), D100.4 (RK), D101.4 (RK), D102.4 (RK), D126.4 (RK), D127.4 (RK), D128.4 (RK), D129.4 (RK), D130.4 (RK), D131.4 (RK), D132.4 (RK), D189.1 (RK), U4.6 (SW4)
SW5_1: D123.3 (GK), D124.3 (GK), D125.3 (GK), D134.3 (GK), D135.3 (GK), D136.3 (GK), D137.3 (GK), D138.3 (GK), D139.3 (GK), D140.3 (GK), D148.3 (GK), D149.3 (GK), D150.3 (GK), D151.3 (GK), D152.3 (GK), D153.3 (GK), U3.7 (SW5)
SW5_2: D95.3 (GK), D96.3 (GK), D97.3 (GK), D98.3 (GK), D99.3 (GK), D100.3 (GK), D101.3 (GK), D102.3 (GK), D126.3 (GK), D127.3 (GK), D128.3 (GK), D129.3 (GK), D130.3 (GK), D131.3 (GK), D132.3 (GK), D189.2 (GK), U4.7 (SW5)
SW6_1: D123.2 (BK), D124.2 (BK), D125.2 (BK), D134.2 (BK), D135.2 (BK), D136.2 (BK), D137.2 (BK), D138.2 (BK), D139.2 (BK), D140.2 (BK), D148.2 (BK), D149.2 (BK), D150.2 (BK), D151.2 (BK), D152.2 (BK), D153.2 (BK), U3.8 (SW6)
SW6_2: D95.2 (BK), D96.2 (BK), D97.2 (BK), D98.2 (BK), D99.2 (BK), D100.2 (BK), D101.2 (BK), D102.2 (BK), D126.2 (BK), D127.2 (BK), D128.2 (BK), D129.2 (BK), D130.2 (BK), D131.2 (BK), D132.2 (BK), D189.3 (BK), U4.8 (SW6)
SW7_1: D87.4 (RK), D88.4 (RK), D89.4 (RK), D90.4 (RK), D91.4 (RK), D92.4 (RK), D93.4 (RK), D94.4 (RK), D118.4 (RK), D119.4 (RK), D120.4 (RK), D121.4 (RK), D122.4 (RK), D173.1 (RK), D188.1 (RK), D190.1 (RK), U3.9 (SW7)
SW7_2: D166.4 (RK), D167.4 (RK), D168.4 (RK), D169.4 (RK), D170.4 (RK), D171.4 (RK), D172.4 (RK), D202.1 (RK), D203.1 (RK), D204.1 (RK), D205.1 (RK), D206.1 (RK), D207.1 (RK), U4.9 (SW7)
SW8_1: D87.3 (GK), D88.3 (GK), D89.3 (GK), D90.3 (GK), D91.3 (GK), D92.3 (GK), D93.3 (GK), D94.3 (GK), D118.3 (GK), D119.3 (GK), D120.3 (GK), D121.3 (GK), D122.3 (GK), D173.2 (GK), D188.2 (GK), D190.2 (GK), U3.10 (SW8)
SW8_2: D166.3 (GK), D167.3 (GK), D168.3 (GK), D169.3 (GK), D170.3 (GK), D171.3 (GK), D172.3 (GK), D202.2 (GK), D203.2 (GK), D204.2 (GK), D205.2 (GK), D206.2 (GK), D207.2 (GK), U4.10 (SW8)
SW9_1: D87.2 (BK), D88.2 (BK), D89.2 (BK), D90.2 (BK), D91.2 (BK), D92.2 (BK), D93.2 (BK), D94.2 (BK), D118.2 (BK), D119.2 (BK), D120.2 (BK), D121.2 (BK), D122.2 (BK), D173.3 (BK), D188.3 (BK), D190.3 (BK), U3.11 (SW9)
SW9_2: D166.2 (BK), D167.2 (BK), D168.2 (BK), D169.2 (BK), D170.2 (BK), D171.2 (BK), D172.2 (BK), D202.3 (BK), D203.3 (BK), D204.3 (BK), D205.3 (BK), D206.3 (BK), D207.3 (BK), U4.11 (SW9)
SW10_1: D103.4 (RK), D104.4 (RK), D105.4 (RK), D106.4 (RK), D107.4 (RK), D108.4 (RK), D109.4 (RK), D110.4 (RK), D174.1 (RK), D175.1 (RK), D176.1 (RK), D177.1 (RK), D178.1 (RK), D179.1 (RK), D180.1 (RK), U3.13 (SW10)
SW10_2: D141.4 (RK), D142.4 (RK), D143.4 (RK), D144.4 (RK), D145.4 (RK), D146.4 (RK), D154.4 (RK), D155.4 (RK), D156.4 (RK), D157.4 (RK), D158.4 (RK), D159.4 (RK), D160.4 (RK), D191.1 (RK), D193.1 (RK), D208.1 (RK), U4.13 (SW10)
SW11_1: D103.3 (GK), D104.3 (GK), D105.3 (GK), D106.3 (GK), D107.3 (GK), D108.3 (GK), D109.3 (GK), D110.3 (GK), D174.2 (GK), D175.2 (GK), D176.2 (GK), D177.2 (GK), D178.2 (GK), D179.2 (GK), D180.2 (GK), U3.14 (SW11)
SW11_2: D141.3 (GK), D142.3 (GK), D143.3 (GK), D144.3 (GK), D145.3 (GK), D146.3 (GK), D154.3 (GK), D155.3 (GK), D156.3 (GK), D157.3 (GK), D158.3 (GK), D159.3 (GK), D160.3 (GK), D191.2 (GK), D193.2 (GK), D208.2 (GK), U4.14 (SW11)
SW12_1: D103.2 (BK), D104.2 (BK), D105.2 (BK), D106.2 (BK), D107.2 (BK), D108.2 (BK), D109.2 (BK), D110.2 (BK), D174.3 (BK), D175.3 (BK), D176.3 (BK), D177.3 (BK), D178.3 (BK), D179.3 (BK), D180.3 (BK), U3.15 (SW12)
SW12_2: D141.2 (BK), D142.2 (BK), D143.2 (BK), D144.2 (BK), D145.2 (BK), D146.2 (BK), D154.2 (BK), D155.2 (BK), D156.2 (BK), D157.2 (BK), D158.2 (BK), D159.2 (BK), D160.2 (BK), D191.3 (BK), D193.3 (BK), D208.3 (BK), U4.15 (SW12)
USB_D_N: IC2.3 (D2), U1.32 (PA11), USBDN1.1
USB_D_P: IC2.1 (D1), U1.33 (PA12), USBDP1.1
USB_RAW_N: IC2.4 (D3), USB1.5 (DN2), USB1.7 (DN1), USBRN1.1
USB_RAW_P: IC2.6 (D4), USB1.6 (DP1), USB1.8 (DP2), USBRP1.1
VBUS: 5V0.1, C7.1, IC1.4 (EN), IC1.5 (IN), USB1.2 (VBUS), USB1.11 (VBUS)

Notes on the sheet:
Keyboard Matrix
POWER
Buck regulator
3.9V
Once you factor in Ceramic VBias derating, these polymers actually have higher C/$ than X5R. AND they aren't piezoelectric.
Important because LED voltage headroom is completely wasted (as heat in the driver)!
Vf at 40mA (absolute maximum instantaneous current) for the RGB used is ~~3.6V. Typ Headroom is 400-500mV on the driver. ~~3.9V power for the LEDs would be ideal for up to ~~25mA instantaneous output (2mA after PWM).
Note that any excess voltage is lost as heat, so lower drive voltage means better efficiency.
USB Input
Encoder
USB capacitance buffer thingy
Limits incrush current, adds MOAR OCP, allows for higher input capacitance while still staying within USB spec (1µF-10µF)
Remember, kids, Always use protection
44u minimum, don't skimp.
PA0 and PA1 are timer2 and ADC in, could be interesting to use later.
Oscillator input (not populated)
Audio
MCU
20k is used elsewhere so I use them here instead of a 40k to keep the BOM down.
Driver "1"
Driver "2"
There are 12 switches on each of the drivers, so each current source pin drives 4 RGB LED's.
CS3
Backlight
Underglow
Driver 1
Driver 2
LED Drivers
The encoders are on keyboard matrix "-1"
Test Points
(Not populated by default)
Note: Pin 4 is common anode. The dot on the PCB denotes common anode pin, not Pin 1.
