Lithovox/lux84/(commit log)

2021-03-25 Replaced BOM file
    [Lux84 BOM.csv, lux84.csv]
2021-03-26 Moved underglow rgb marking
    Schematic is RGBA, with common anode pin 4. Part used is ABGR, with common anode pin 1. Moved silkscreen marking to Pin 4 on PCB to denote common anode, matching the marking on the part.
    [lux84.sch]
